At-SiliconValley/PetLocation/01_notes/牛马定位器_原理图.pdf

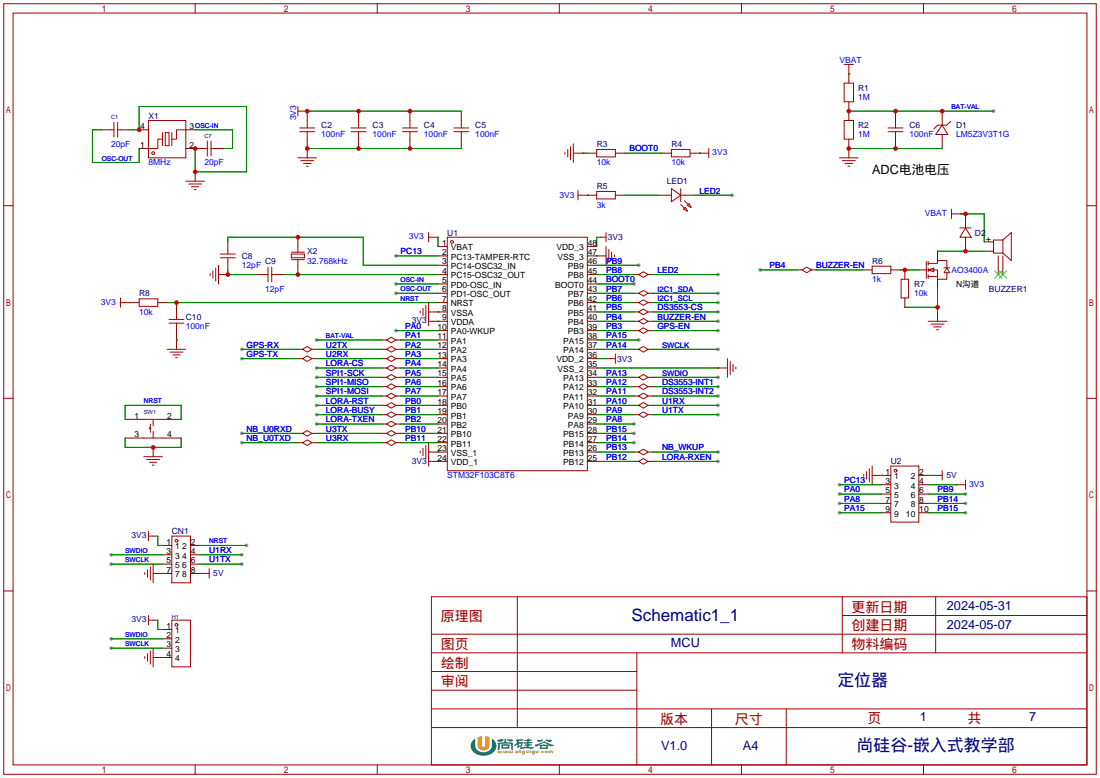
[picture p7: page 1]

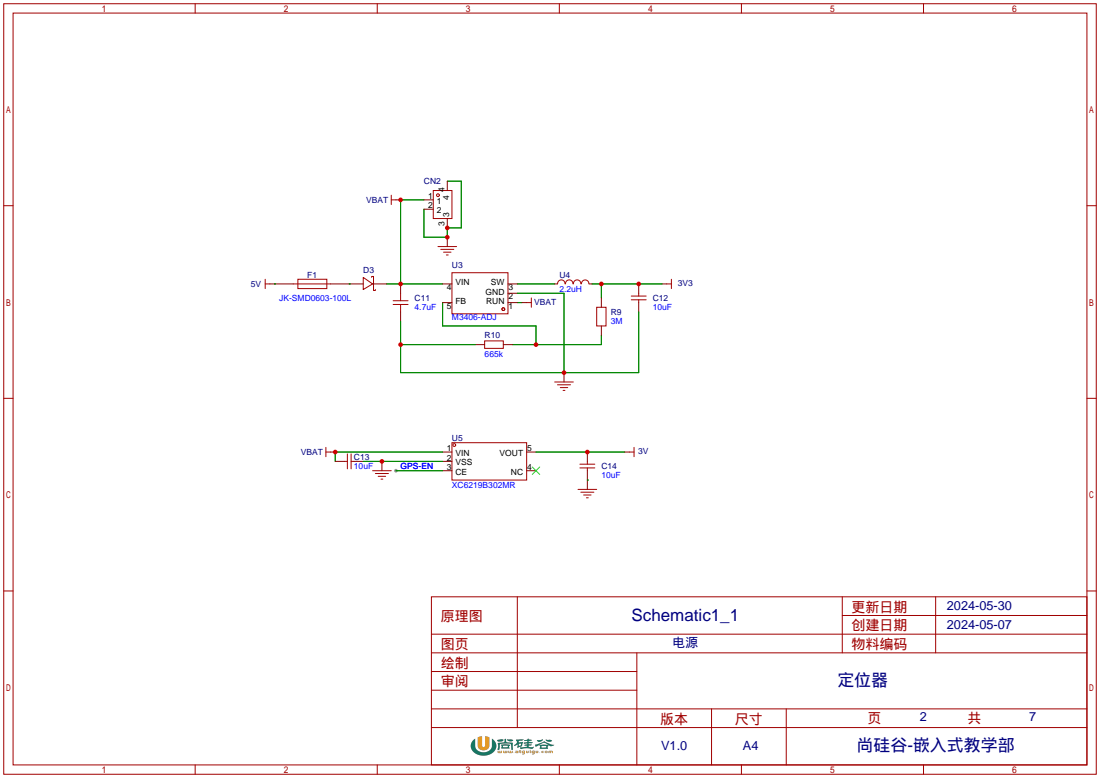
[picture p8: page 2]

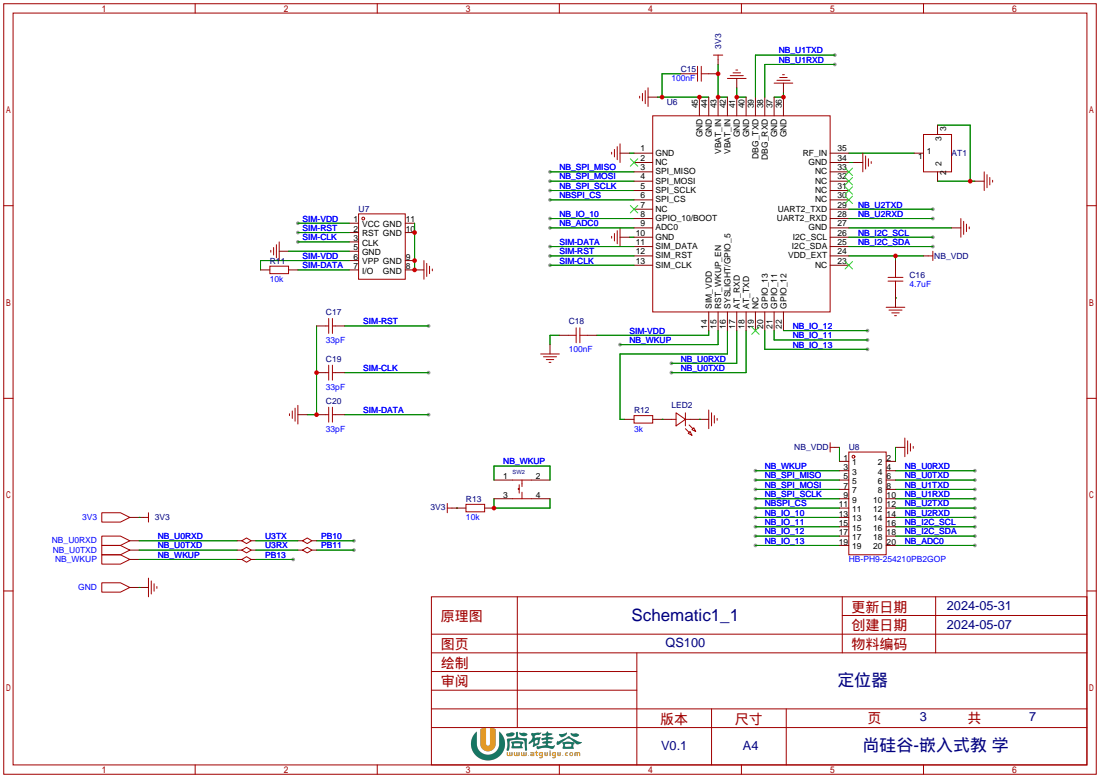
[picture p9: page 3]

NC 23 VDD_EXT 24 I2C_SDA 25 I2C_SCL 26 GND 27 UART2_RXD 28 UART2_TXD 29 NC 30 NC 31 NC 32 NC 33 GND 34 RF_IN 35 GND ³⁶ GND ³⁷ DBG_RXD ³⁸ DBG_TXD ³⁹ GND ⁴⁰ GND ⁴¹ VBAT_IN ⁴² VBAT_IN ⁴³ GND ⁴⁴ GND ⁴⁵

审阅

绘制

### 创建日期 物料编码

原理图 | 更新日期

图页

## 定位器

2024-05-31

# 2024-05-07 Schematic1_1

DS3553

V0.1 | A4 | 尚硅谷-嵌入式教 学

INT2 1

SDA 2

VDDIO 3

NC 4

INT1 5 | NC 6

VDD 7
GND 8

GND 9
CS 10 | NC 11 SCL 12

U9

I2C1_SDA
I2C1_SCL
DS3553-CS

3V3
I2C1_SDA
I2C1_SCL
DS3553-CS

GND

I2C1_SDA
I2C1_SCL
DS3553-CS

C21
100nF

3V3

3V3

R14
10k
R15
10k DS3553-INT1
DS3553-INT2
DS3553-INT1 | DS3553-INT1 | PA12
DS3553-INT2 | DS3553-INT2 | PA11 PB5

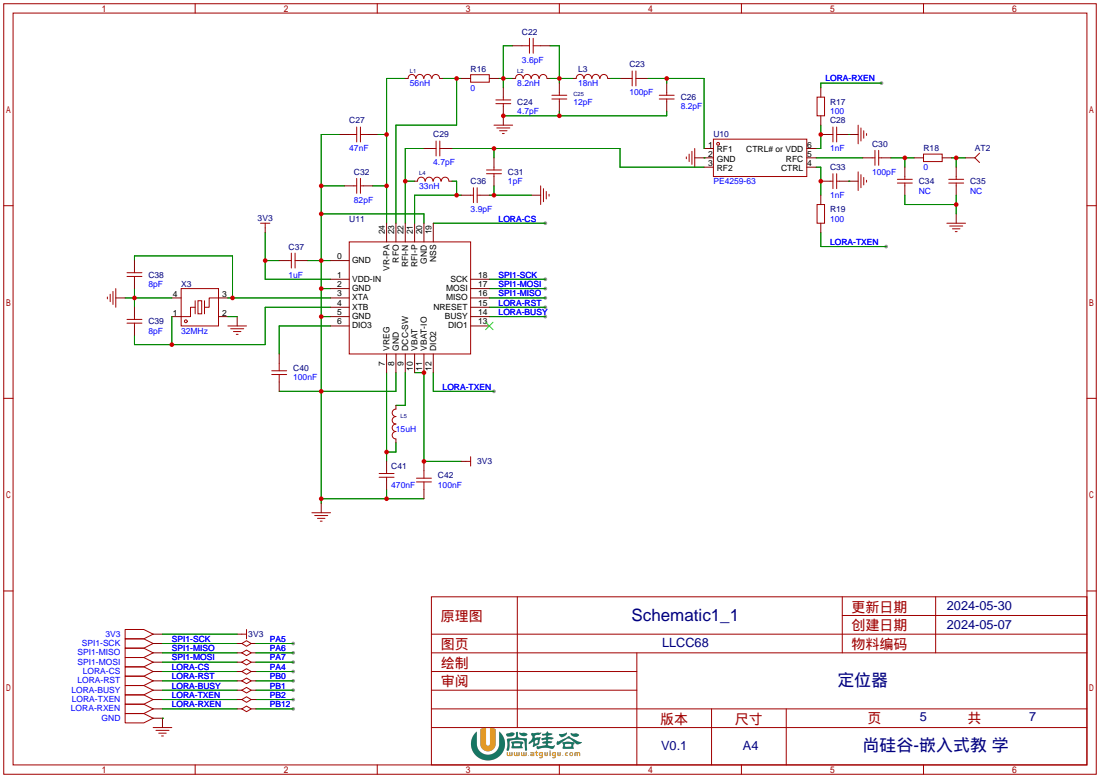
[picture p10: page 5]

DIO1 13 BUSY 14 NRESET 15 MISO 16 MOSI 17 SCK 18 NSS ¹⁹ GND ²⁰ RFI-P ²¹ RFI-N ²² RFO ²³ VR⁻PA ²⁴

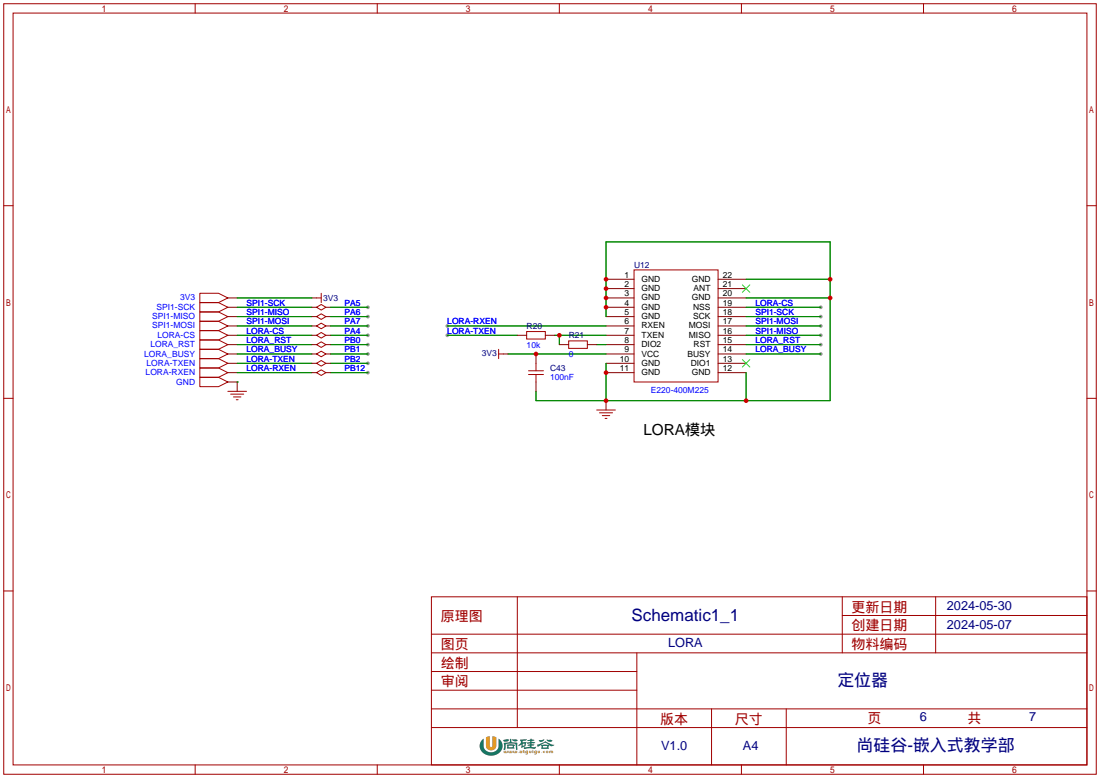
[picture p11: page 6]

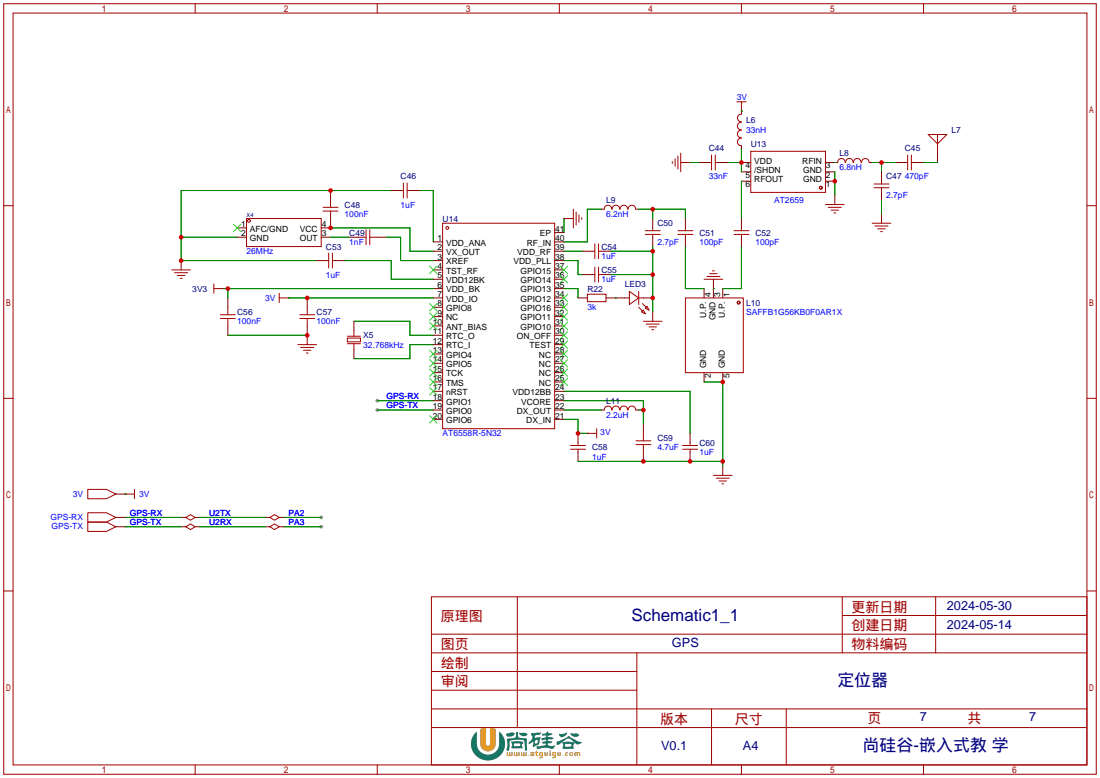
[picture p12: page 7]
