At-SiliconValley/PetLocation/gateway/Core/Inc/main.h

#define LoRa_BUSY_Pin GPIO_PIN_2
#define LoRa_BUSY_GPIO_Port GPIOE
#define LoRa_RXEN_Pin GPIO_PIN_5
#define LoRa_RXEN_GPIO_Port GPIOE
#define LoRa_TXEN_Pin GPIO_PIN_6
#define LoRa_TXEN_GPIO_Port GPIOE
#define W5500_INT_Pin GPIO_PIN_6
#define W5500_INT_GPIO_Port GPIOG
#define W5500_RST_Pin GPIO_PIN_7
#define W5500_RST_GPIO_Port GPIOG
#define W5500_CS_Pin GPIO_PIN_3
#define W5500_CS_GPIO_Port GPIOD
#define LoRa_RST_Pin GPIO_PIN_13
#define LoRa_RST_GPIO_Port GPIOG
#define LoRa_CS_Pin GPIO_PIN_14
#define LoRa_CS_GPIO_Port GPIOG
