At-SiliconValley/PetLocation/location/Int/QS100/Int_QS100.h

#ifndef __INT_QS100_H__
#define __INT_QS100_H__
#include "usart.h"
#include "Com_Delay.h"
#include "Com_Debug.h"
#include "string.h"
#include "Com_Status.h"
#include "stdlib.h"
#include ""


void Int_QS100_Init(void);

void Int_QS100_WakeUp(void);

Com_Status_T Int_QS100_IsNetWork(void);

Com_Status_T Int_QS100_CreateSocket(void);

Com_Status_T Int_QS100_ConnectServer(uint8_t *serverIP, uint16_t port);

Com_Status_T Int_QS100_SendData2Server(uint16_t length, uint8_t *data);

Com_Status_T Int_QS100_UploadData(uint8_t *serverIP, uint16_t port, uint16_t length, uint8_t *data);


void Int_QS100_EnterLowPower(void);
void Int_QS100_LeaveLowPower(void);

#endif /* __INT_QS100_H__ */
